Any-Winter-4079/LLM-Arduino-Robot/computer/LMM/input_images/left_turn.png

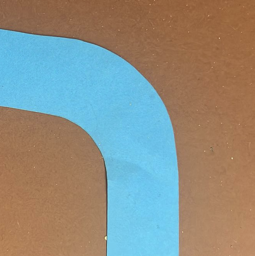
computer/LMM/input_images/left_turn.png
