Any-Winter-4079/LLM-Arduino-Robot/computer/LMM/input_images/right_turn.png

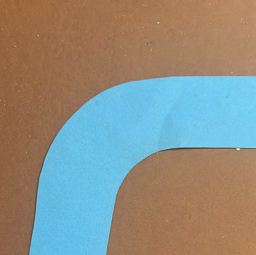
computer/LMM/input_images/right_turn.png
