Any-Winter-4079/LLM-Arduino-Robot/computer/LMM/input_images/straight_ahead.png

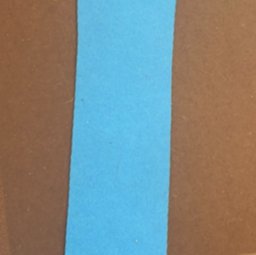
computer/LMM/input_images/straight_ahead.png
