Any-Winter-4079/LLM-Arduino-Robot/venv-pip-install.txt

pip install tensorflow-macos==2.14.0
pip install tensorflow-metal
pip install requests
pip install websockets
pip install pydub
pip install deepface
pip install ultralytics
pip install TTS -c tts-constraints.txt
pip install openai
pip uninstall torch torchvision torchaudio
pip3 install --pre torch torchvision torchaudio --index-url https://download.pytorch.org/whl/nightly/cpu
pip install mediapipe
pip install facenet-pytorch
pip install llama_cpp_python==0.2.44
pip install datasets
pip install anthropic
pip install python-dotenv
