Any-Winter-4079/LLM-Arduino-Robot/computer/calibration/images/corners_side_by_side/20240220_214239_side_by_side.jpg

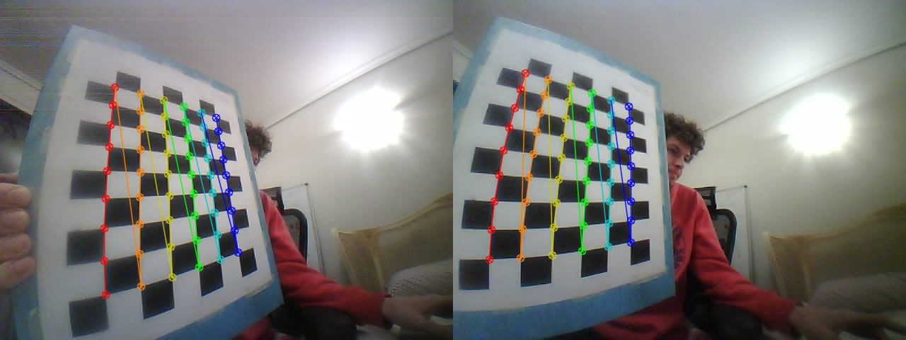
computer/calibration/images/corners_side_by_side/20240220_214239_side_by_side.jpg
