Any-Winter-4079/LLM-Arduino-Robot/computer/LMM/results/LLaVA-1.5-13b-4bit_find_next_move_for_left_turn_marked.png

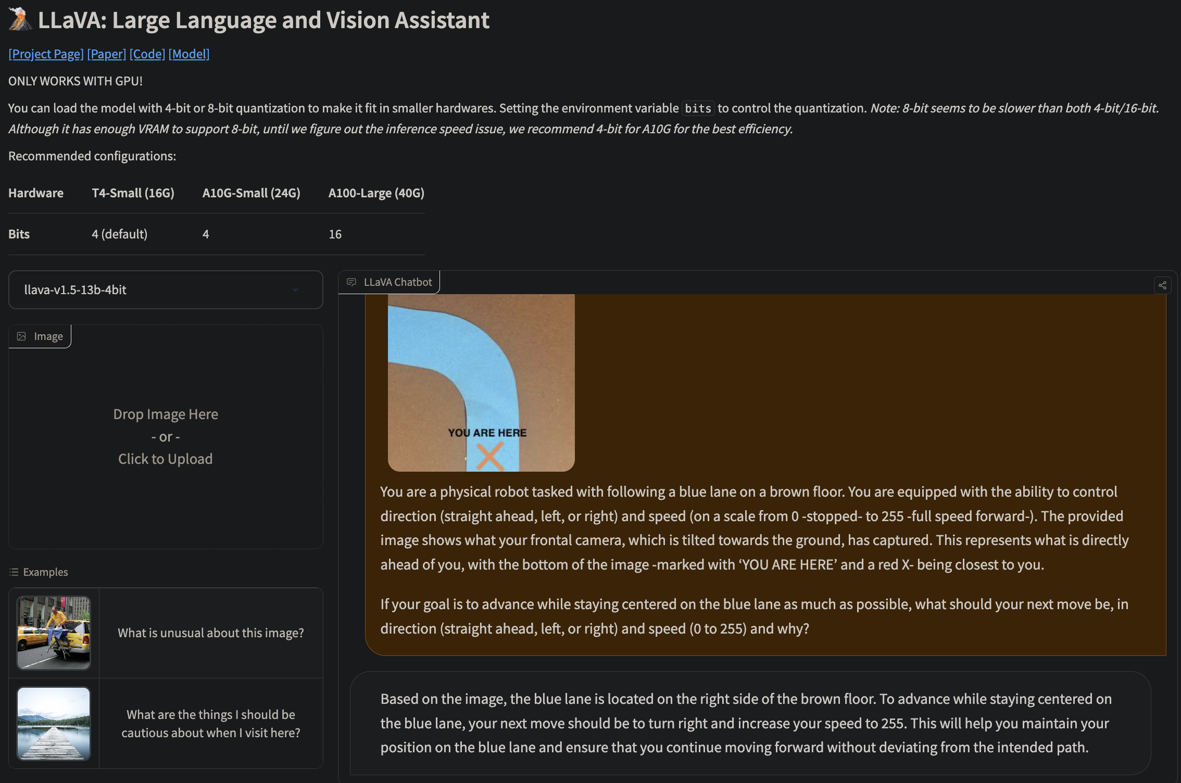
computer/LMM/results/LLaVA-1.5-13b-4bit_find_next_move_for_left_turn_marked.png
