Any-Winter-4079/LLM-Arduino-Robot/computer/LMM/results/moondream2_detail_image_for_left_turn.png

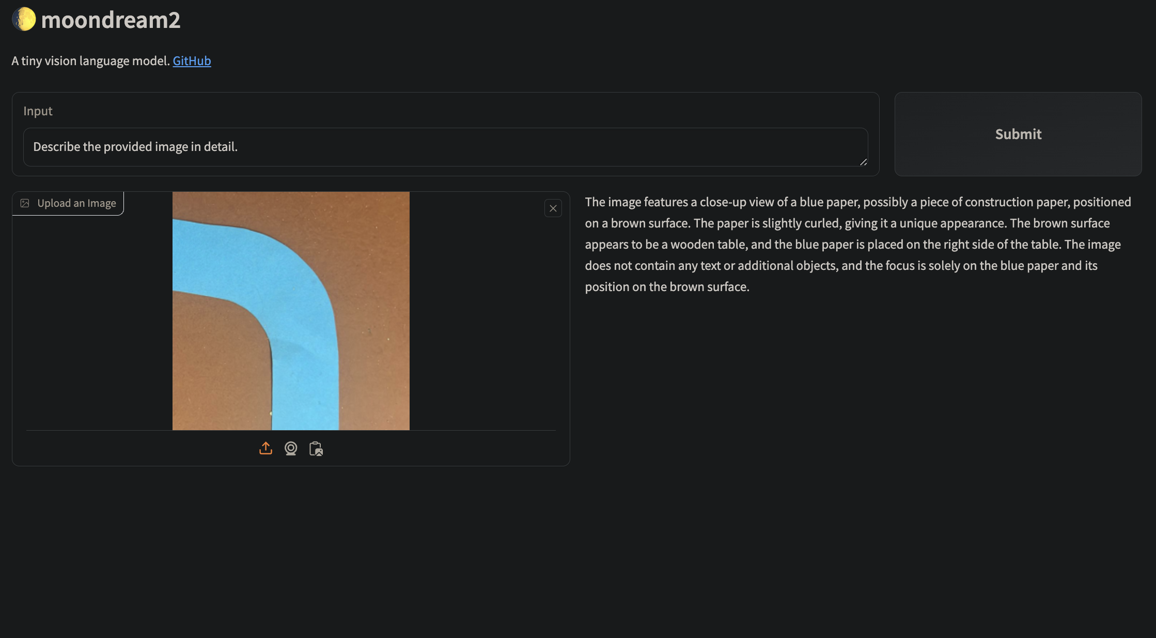
computer/LMM/results/moondream2_detail_image_for_left_turn.png
