Any-Winter-4079/LLM-Arduino-Robot/computer/LMM/results/moondream2_detail_image_for_straight_ahead.png

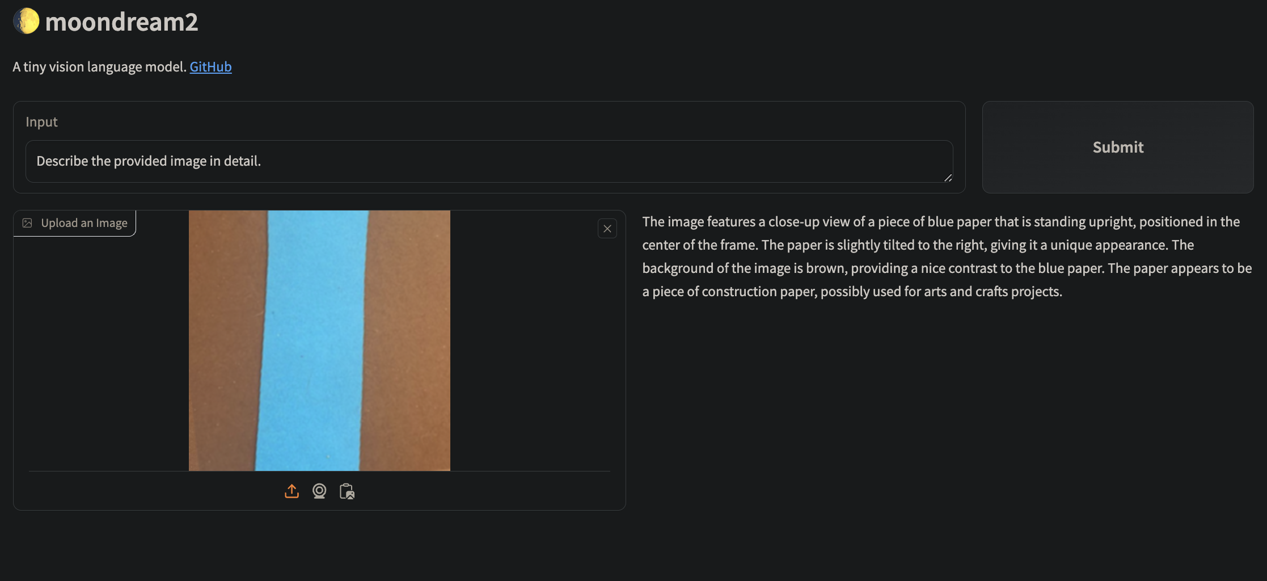
computer/LMM/results/moondream2_detail_image_for_straight_ahead.png
