Any-Winter-4079/LLM-Arduino-Robot/computer/LMM/results/moondream2_find_next_move_for_arrow_left_marked.png

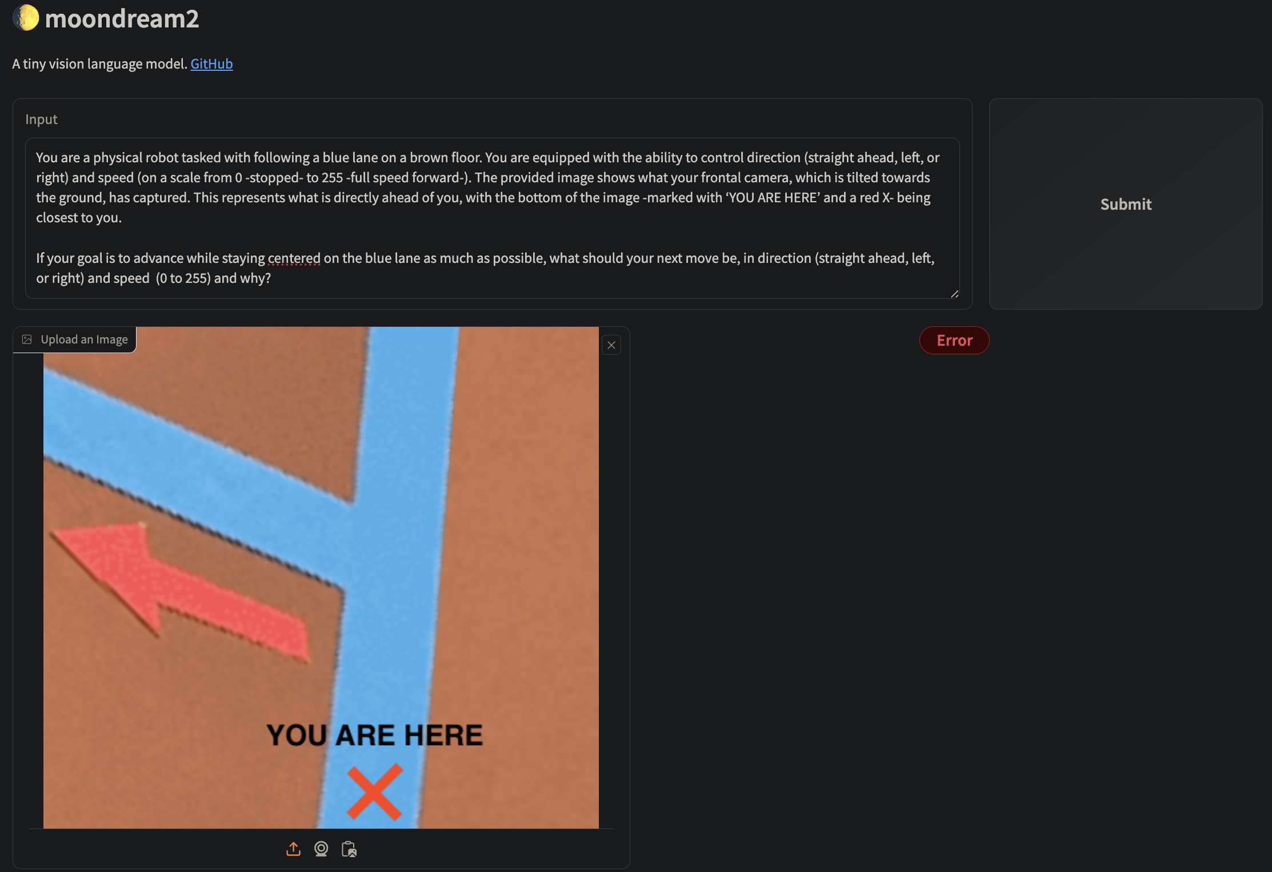
computer/LMM/results/moondream2_find_next_move_for_arrow_left_marked.png
