Any-Winter-4079/LLM-Arduino-Robot/computer/LMM/results/moondream2_find_next_move_for_left_turn.png

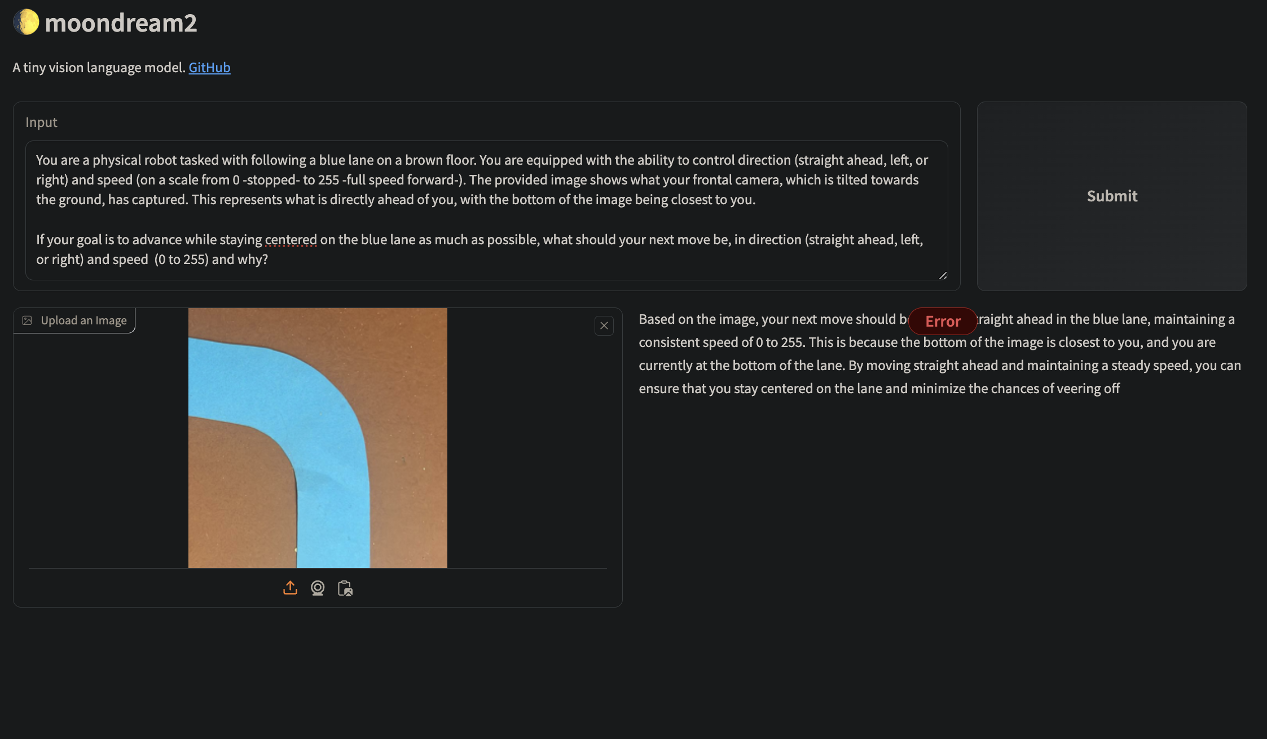
computer/LMM/results/moondream2_find_next_move_for_left_turn.png
