Any-Winter-4079/LLM-Arduino-Robot/computer/LMM/results/nanoLLaVA-qwen-1.5_detail_image_for_left_turn.png

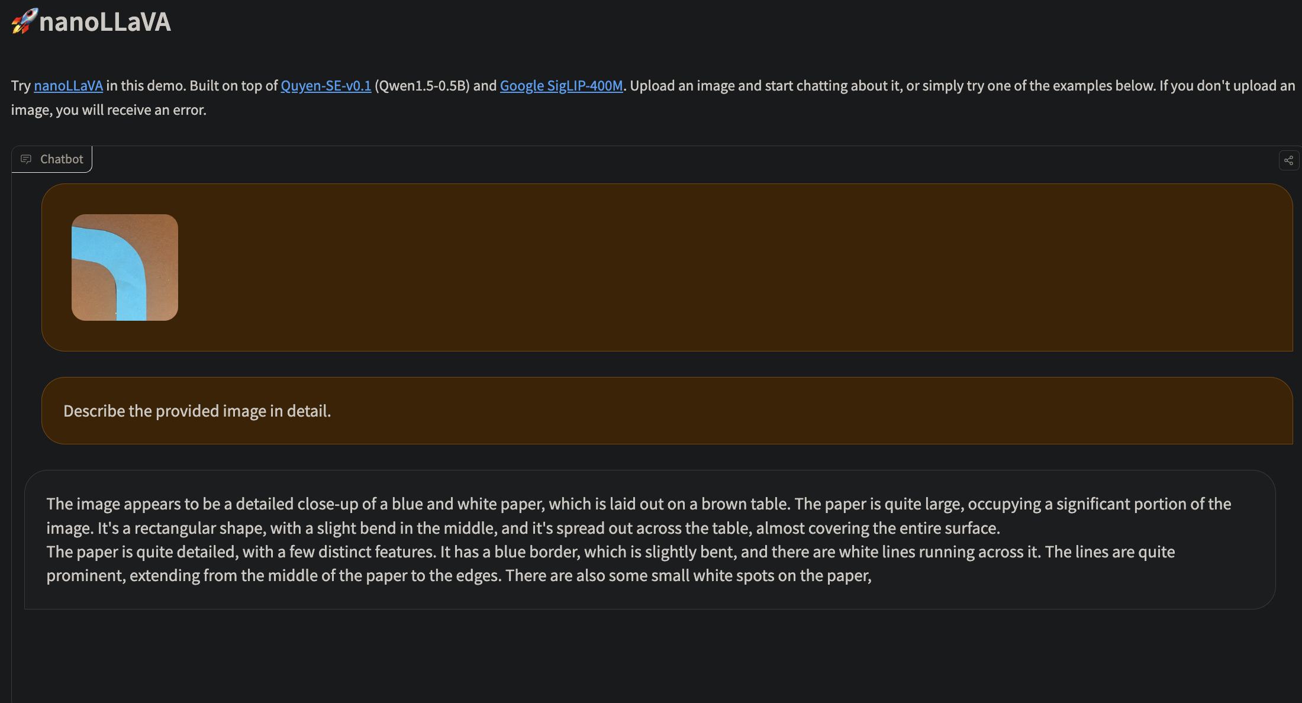
computer/LMM/results/nanoLLaVA-qwen-1.5_detail_image_for_left_turn.png
