Any-Winter-4079/LLM-Arduino-Robot/computer/LMM/results/nanoLLaVA-qwen-1.5_find_next_move_for_right_turn.png

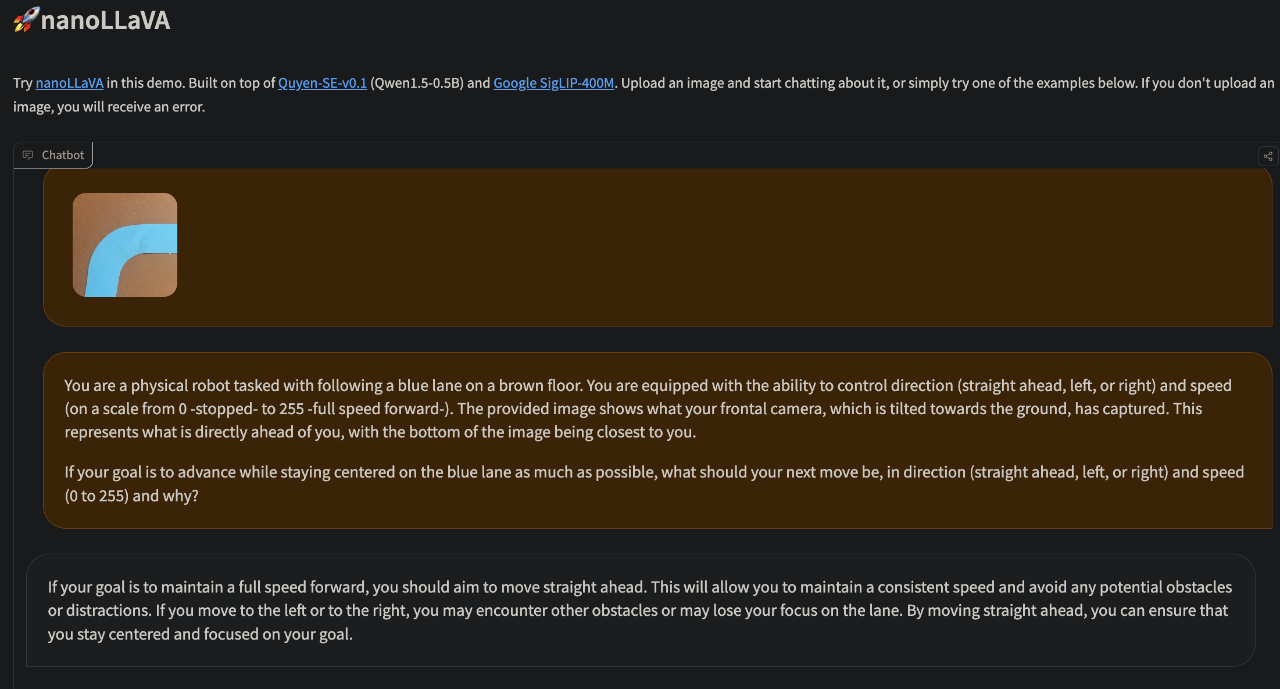
computer/LMM/results/nanoLLaVA-qwen-1.5_find_next_move_for_right_turn.png
