Any-Winter-4079/LLM-Arduino-Robot/computer/LMM/results/nanoLLaVA-qwen-1.5_find_next_move_for_straight_ahead.png

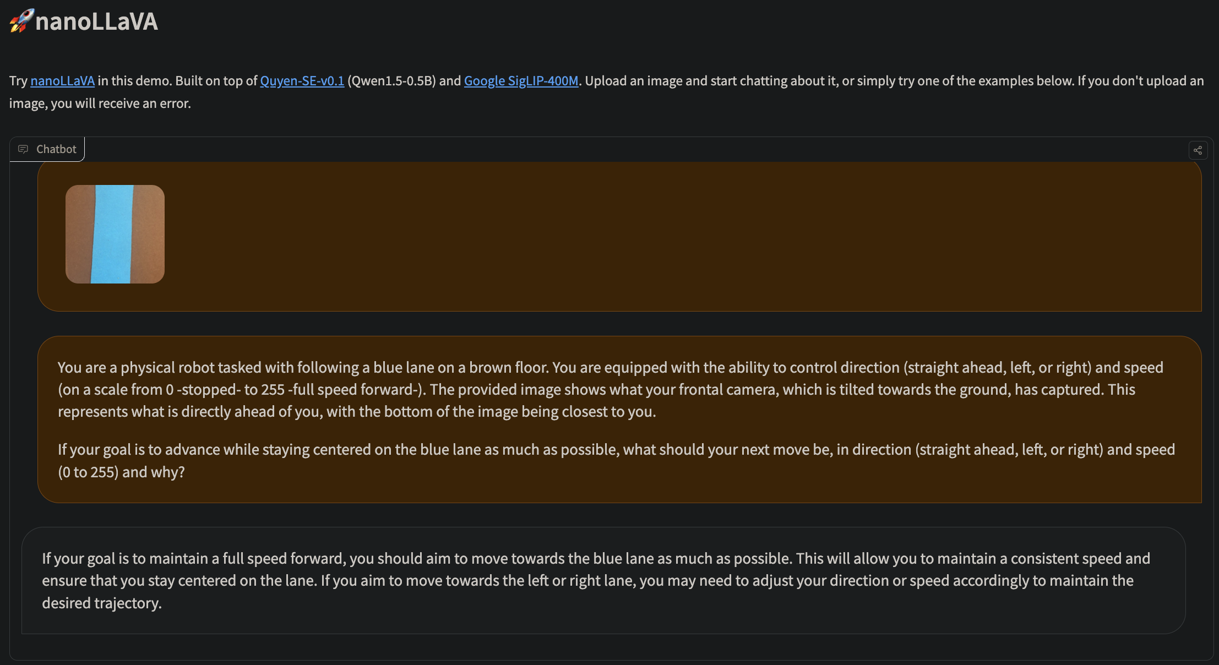
computer/LMM/results/nanoLLaVA-qwen-1.5_find_next_move_for_straight_ahead.png
