Any-Winter-4079/LLM-Arduino-Robot/computer/undistortion_and_rectification/images/undistorted_and_rectified_calibration_images/stereo_image_20240220_213905.jpg

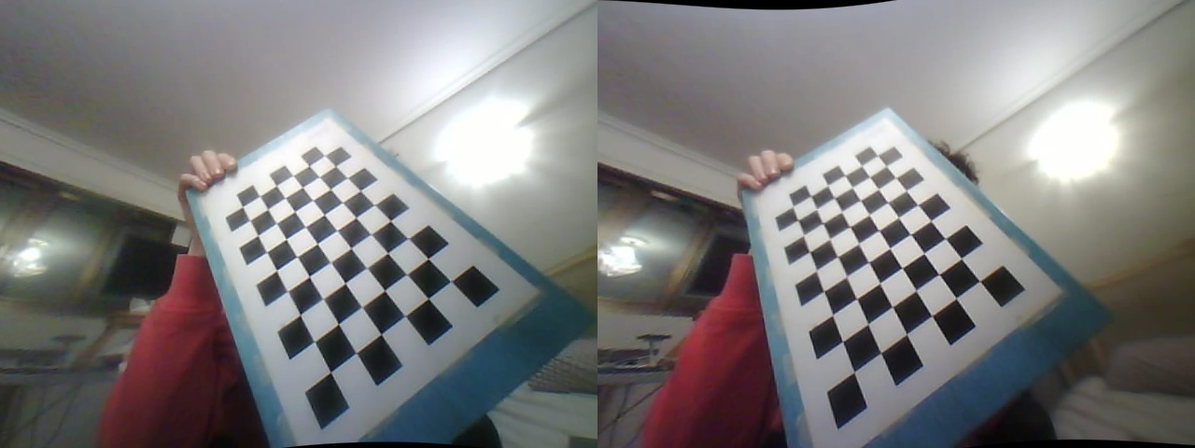
computer/undistortion_and_rectification/images/undistorted_and_rectified_calibration_images/stereo_image_20240220_213905.jpg
