Any-Winter-4079/LLM-Arduino-Robot/(commit log)

2024-10-07 add arduino sketches (motors and servos tests and production)
2024-10-08 add computer servo and motor code
2024-10-17 add several esp32 pinouts
2024-10-17 update several esp32 pinouts
2025-01-08 arduino update
2025-01-08 esp32 documentation
2025-01-08 update Arduino README
2025-01-09 seervo and motor test scripts, and other updates
2025-01-09 update esp32/ readme
2025-01-09 add calibration/ readme
2025-03-26 add camera calib params
2025-03-28 motors, servos update
